jbarnoud/PinchGlove/Assets/finish.jpg

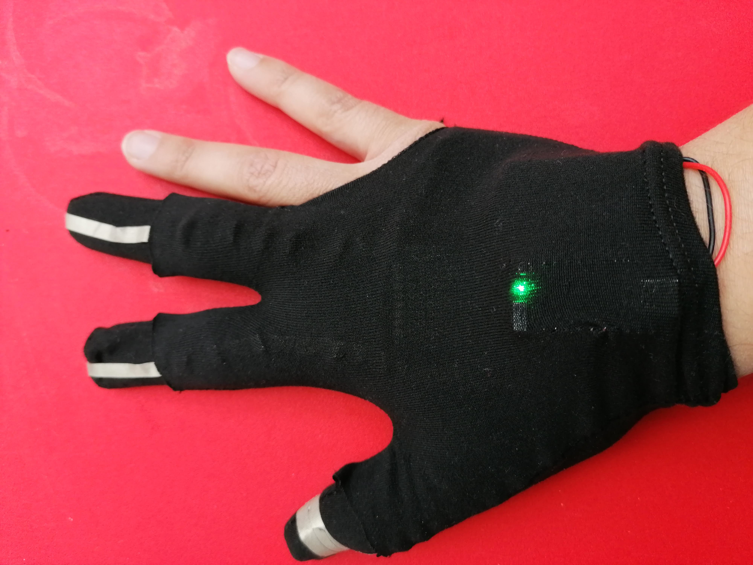
Assets/finish.jpg
