jbarnoud/PinchGlove/Assets/hand_back.jpg

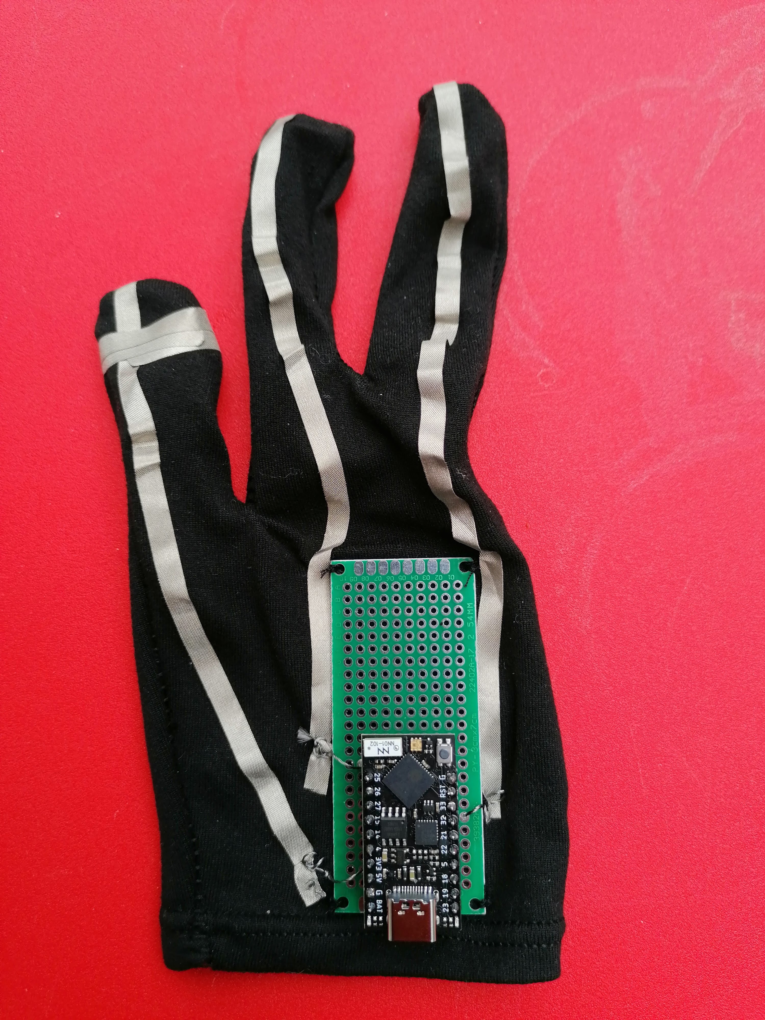
Assets/hand_back.jpg
