jbarnoud/PinchGlove/Assets/hand_palm.jpg

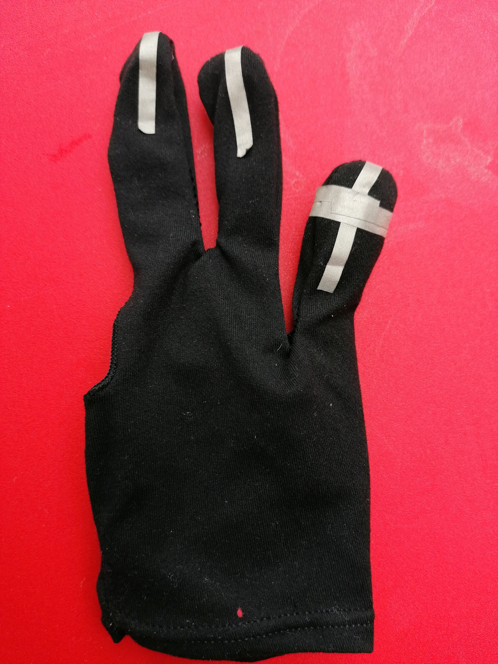
Assets/hand_palm.jpg
