jbarnoud/PinchGlove/(commit log)

2021-04-14 Add the BOM
2021-04-15 Add the battery in the part list
